bve/gnw-ble-swd/(commit log)

2026-09-26 Document the 1.8 V SuperMini hardware modification with an annotated image
2026-09-26 Show the capacitor-pad VDD/VDDH solder bridge
2026-09-26 Replace handwritten solder-point annotations with clean labels
2026-09-26 Add the BLE client and a four-step wireless retro-go flashing guide
2026-09-26 Document both Game & Watch headers and five-wire power connection
2026-09-26 Document optional USB and charger removal and idle power use
